ladyada/AUMacropad/README.md

# AUMacropad
Contains design files for AU Macropad which is a modded version of the Adafruit Macropad
