ladyada/AUMacropad/(commit log)

2023-06-06 swap gnd and usbboot to match original macropad
    [AU_MacroPad.brd, AU_MacroPad.sch]
2023-06-06 add bottom fiducials, clean up silk due to other side OLED
    [AU_MacroPad.brd, AU_MacroPad.sch]
2023-08-16 Connector rotated 180 degrees and traces re-routed
    [AU_MacroPad.brd, AU_MacroPad.sch]
2023-08-21 Add files via upload
    Built from Limor's files. Rotated connector 180 degrees and re-routed.
    [AU_MacroPad.brd, AU_MacroPad.sch]
2023-08-21 rotated connector
    [AU_MacroPad.brd]
2023-08-21 updated library
    [AU_MacroPad.sch]
2024-05-15 added encoder!
